cepr/canbuz-1977-vw-bus-ecu/models/OctaPAK_7_1.STEP

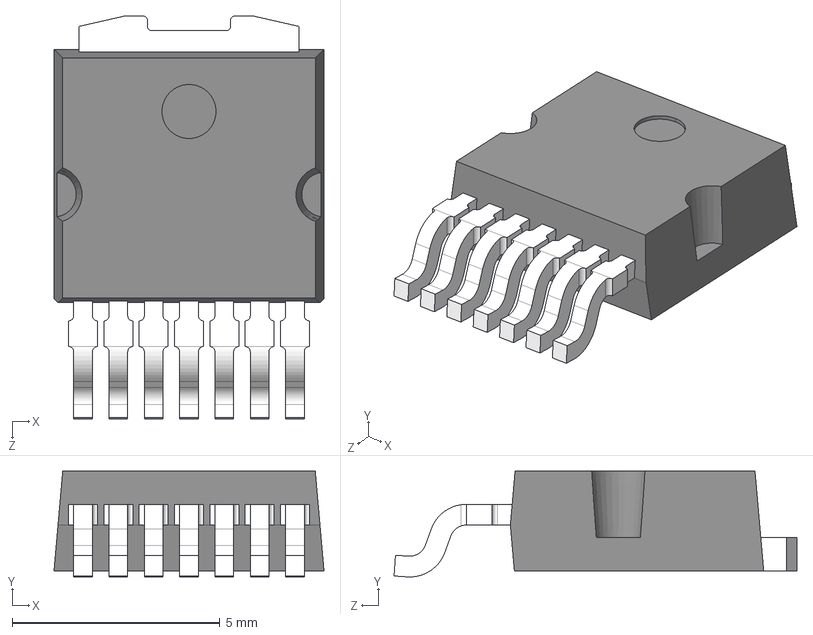
[picture p1: CAD file, 2023-06-19]
models/OctaPAK_7_1.STEP
6.50 x 2.55 x 9.70 mm
