cepr/canbuz-1977-vw-bus-ecu/models/TerminalBlock_On-Shore-Technology_ED120-3DS_1x03_P5.08mm_Vertical.step

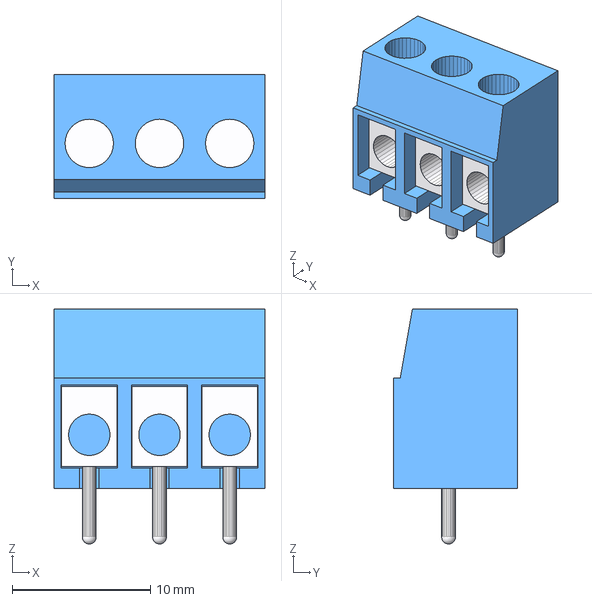
[picture p2: CAD file, 2023-06-19]
models/TerminalBlock_On-Shore-Technology_ED120-3DS_1x03_P5.08mm_Vertical.step
15.2 x 9.00 x 17.0 mm
