cepr/canbuz-1977-vw-bus-ecu/models/JST_SH_SM04B-SRSS-TB_1x04-1MP_P1.00mm_Horizontal.STEP

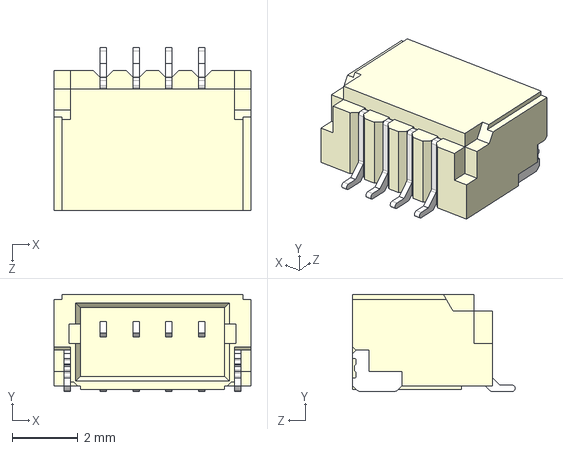
[picture p3: CAD file, 2023-06-19]
models/JST_SH_SM04B-SRSS-TB_1x04-1MP_P1.00mm_Horizontal.STEP
6.00 x 2.96 x 4.95 mm
