cepr/canbuz-1977-vw-bus-ecu/models/TerminalBlock_On-Shore-Technology_ED120-2DS_1x02_P5.08mm_Vertical.step

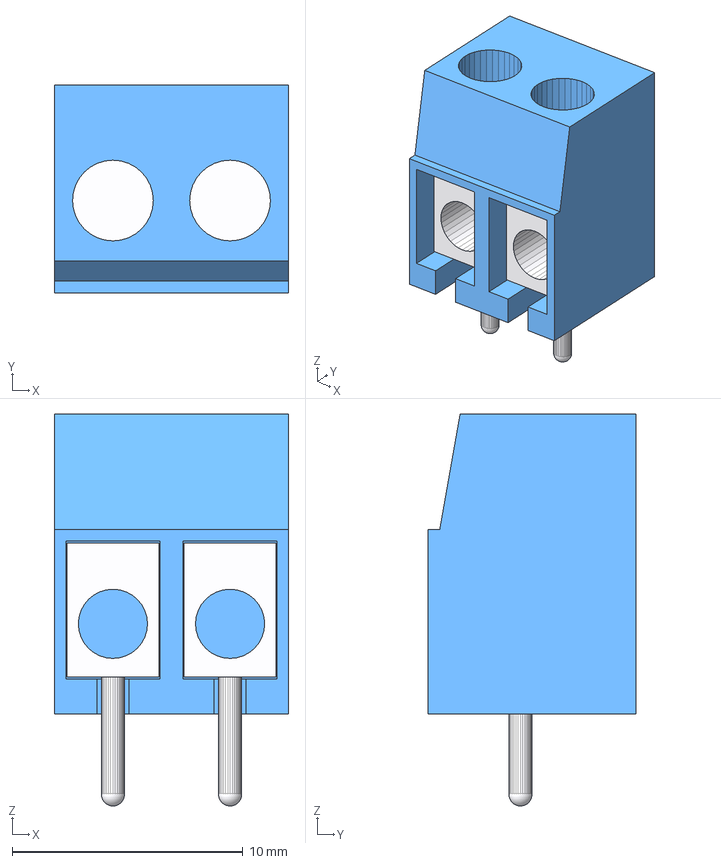
[picture p4: CAD file, 2023-06-19]
models/TerminalBlock_On-Shore-Technology_ED120-2DS_1x02_P5.08mm_Vertical.step
10.2 x 9.00 x 17.0 mm
