cepr/canbuz-1977-vw-bus-ecu/models/tsr2_3d_drawing.step

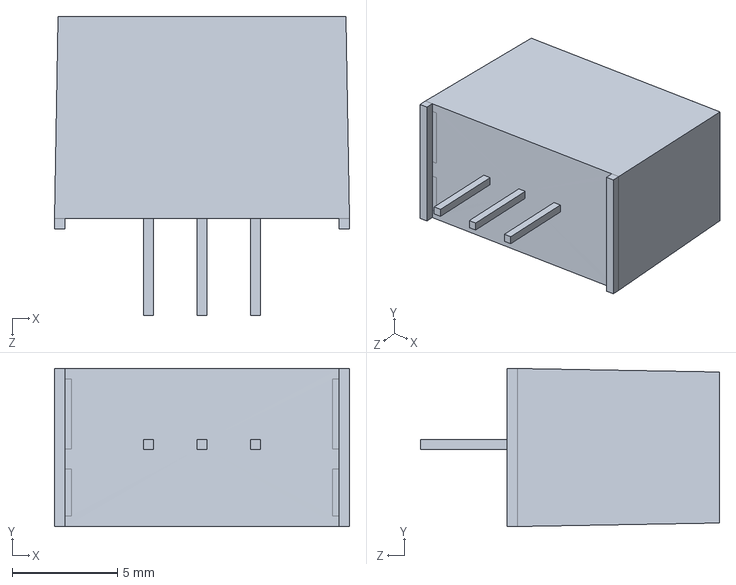
[picture p5: CAD file, 2023-06-19]
models/tsr2_3d_drawing.step
14.0 x 7.50 x 14.2 mm
