cepr/canbuz-1977-vw-bus-ecu/models/TerminalBlock_On-Shore-Technology_ED120-6DS_1x06_P5.08mm_Vertical.step

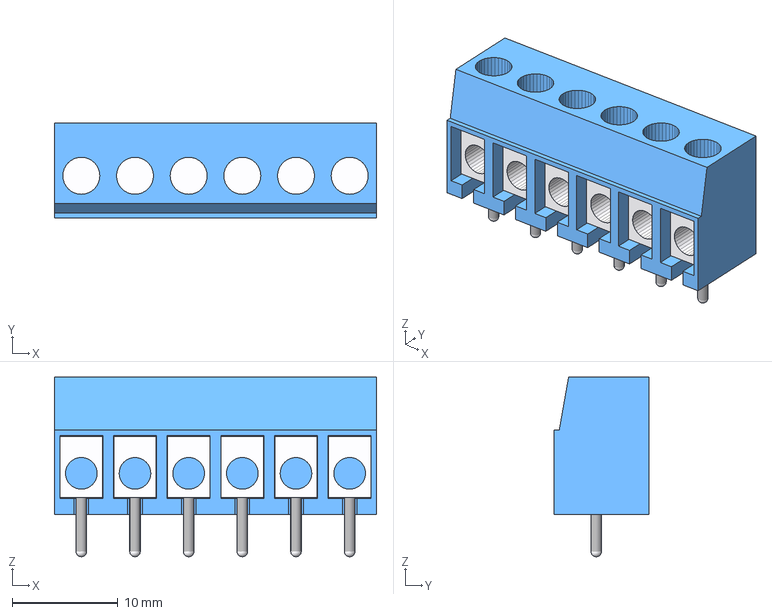
[picture p6: CAD file, 2023-06-19]
models/TerminalBlock_On-Shore-Technology_ED120-6DS_1x06_P5.08mm_Vertical.step
30.5 x 9.00 x 17.0 mm
