cepr/canbuz-1977-vw-bus-ecu/models/TerminalBlock_On-Shore-Technology_ED120-4DS_1x04_P5.08mm_Vertical.step

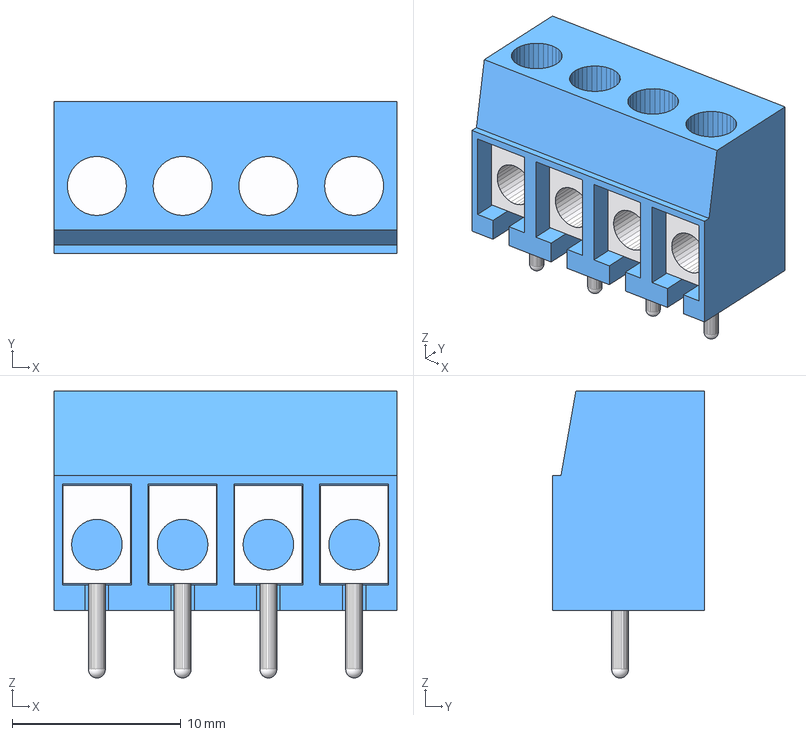
[picture p7: CAD file, 2023-06-19]
models/TerminalBlock_On-Shore-Technology_ED120-4DS_1x04_P5.08mm_Vertical.step
20.3 x 9.00 x 17.0 mm
