cepr/canbuz-1977-vw-bus-ecu/canbuz-1977-vw-bus-ecu.kicad_pcb

## KiCad design canbuz-1977-vw-bus-ecu.kicad_pcb (2023-08-31)

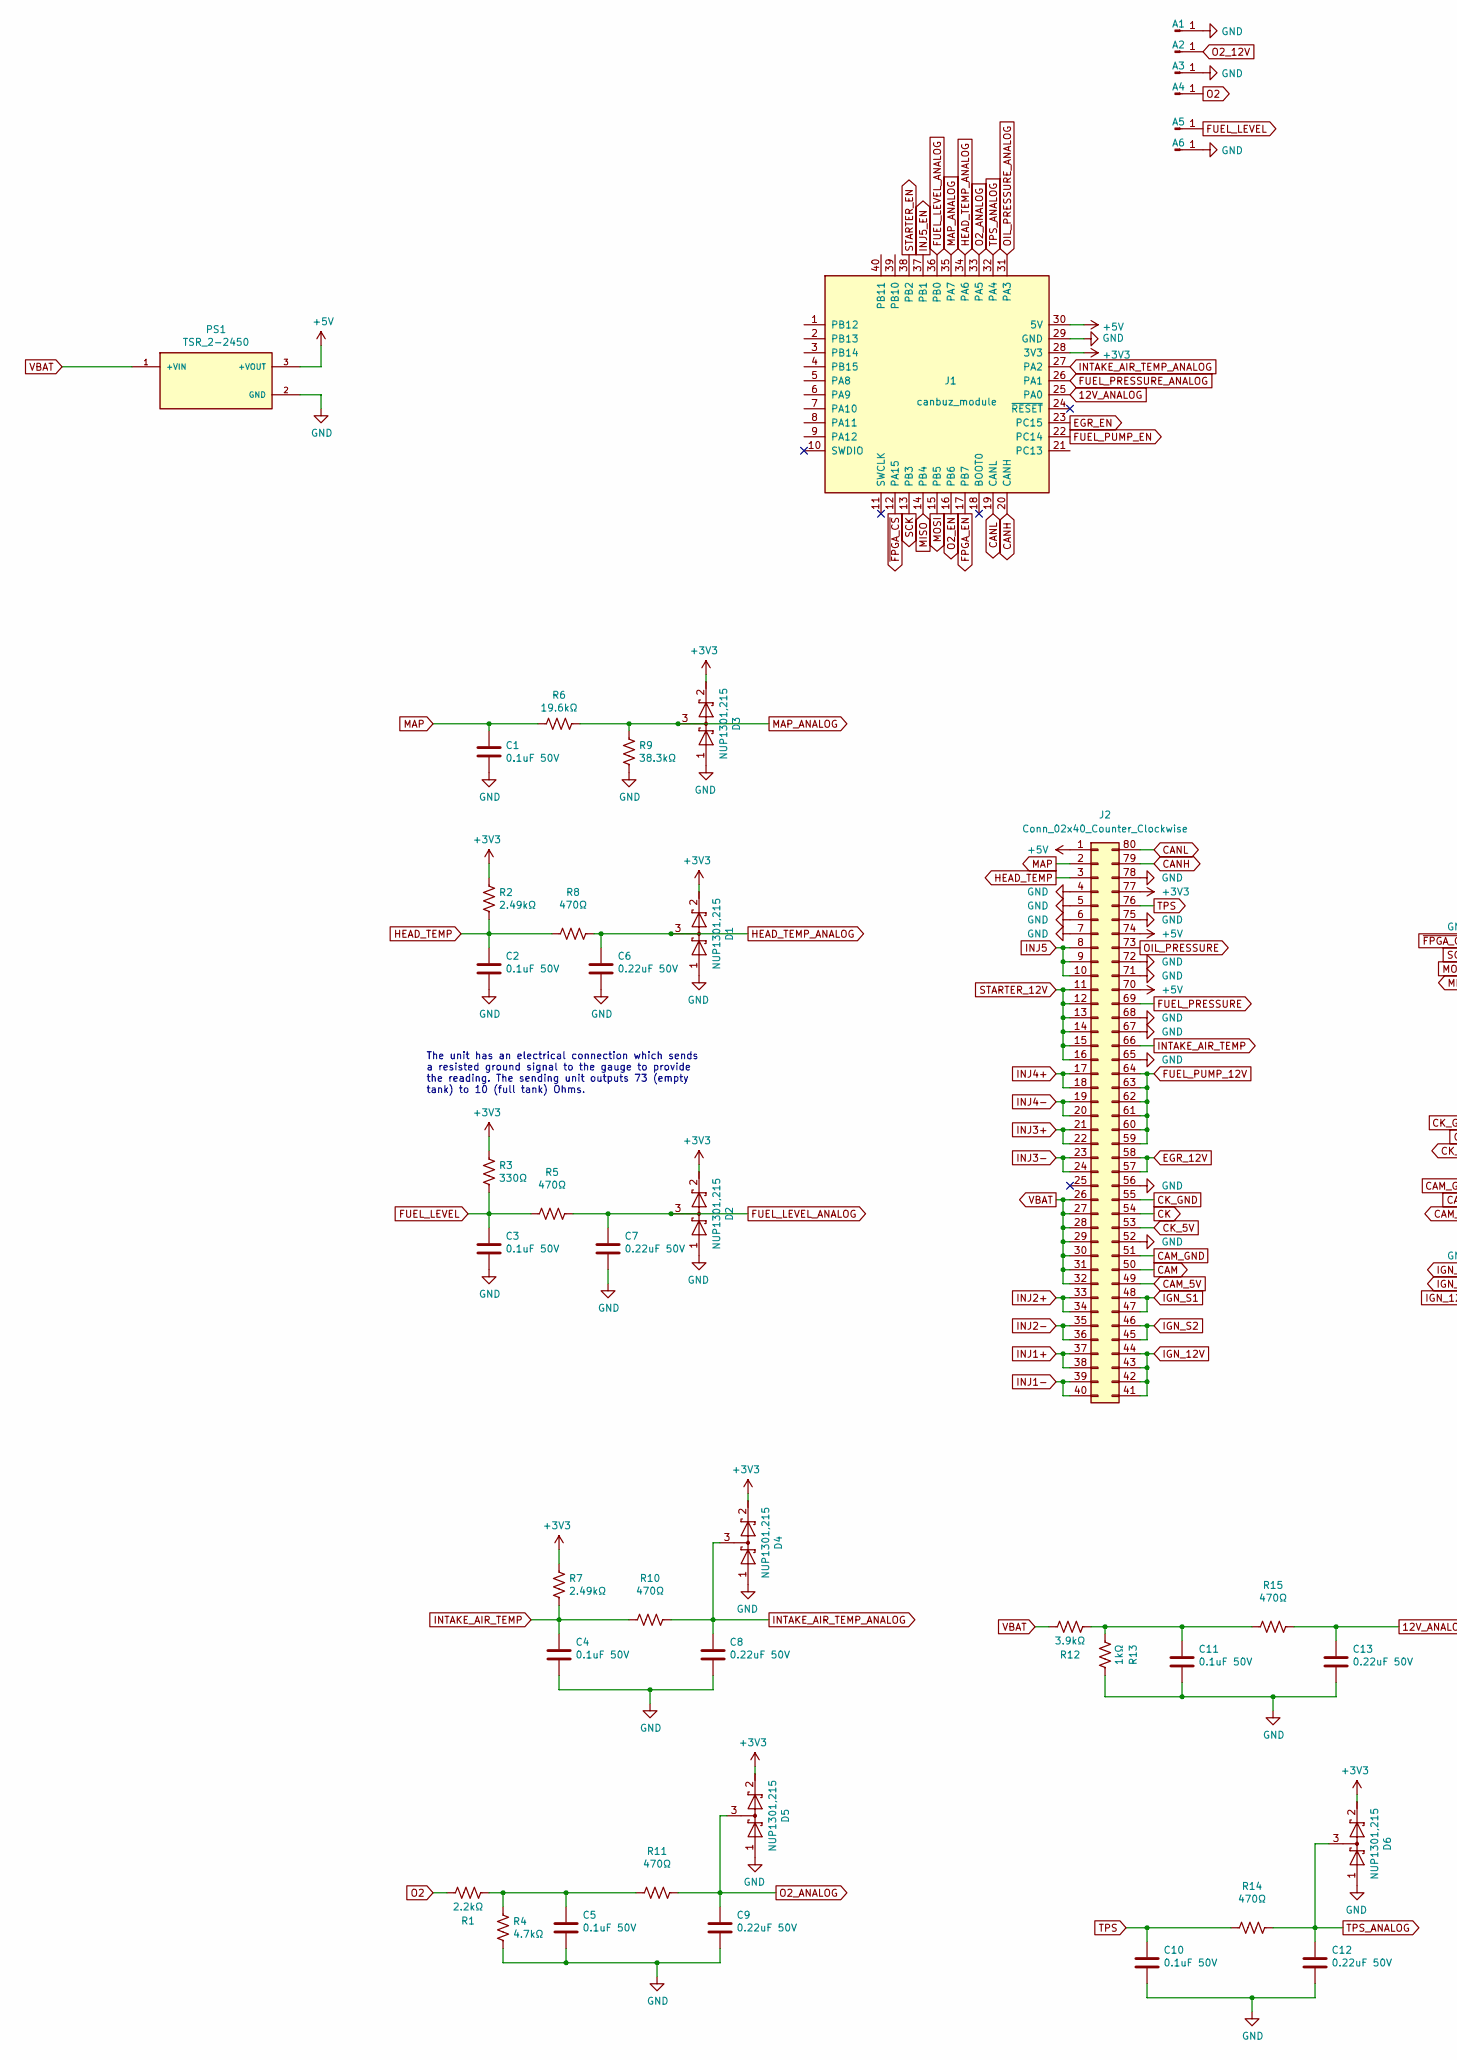
[picture p8: schematic canbuz-1977-vw-bus-ecu.kicad_sch, part in row 1, column 1]

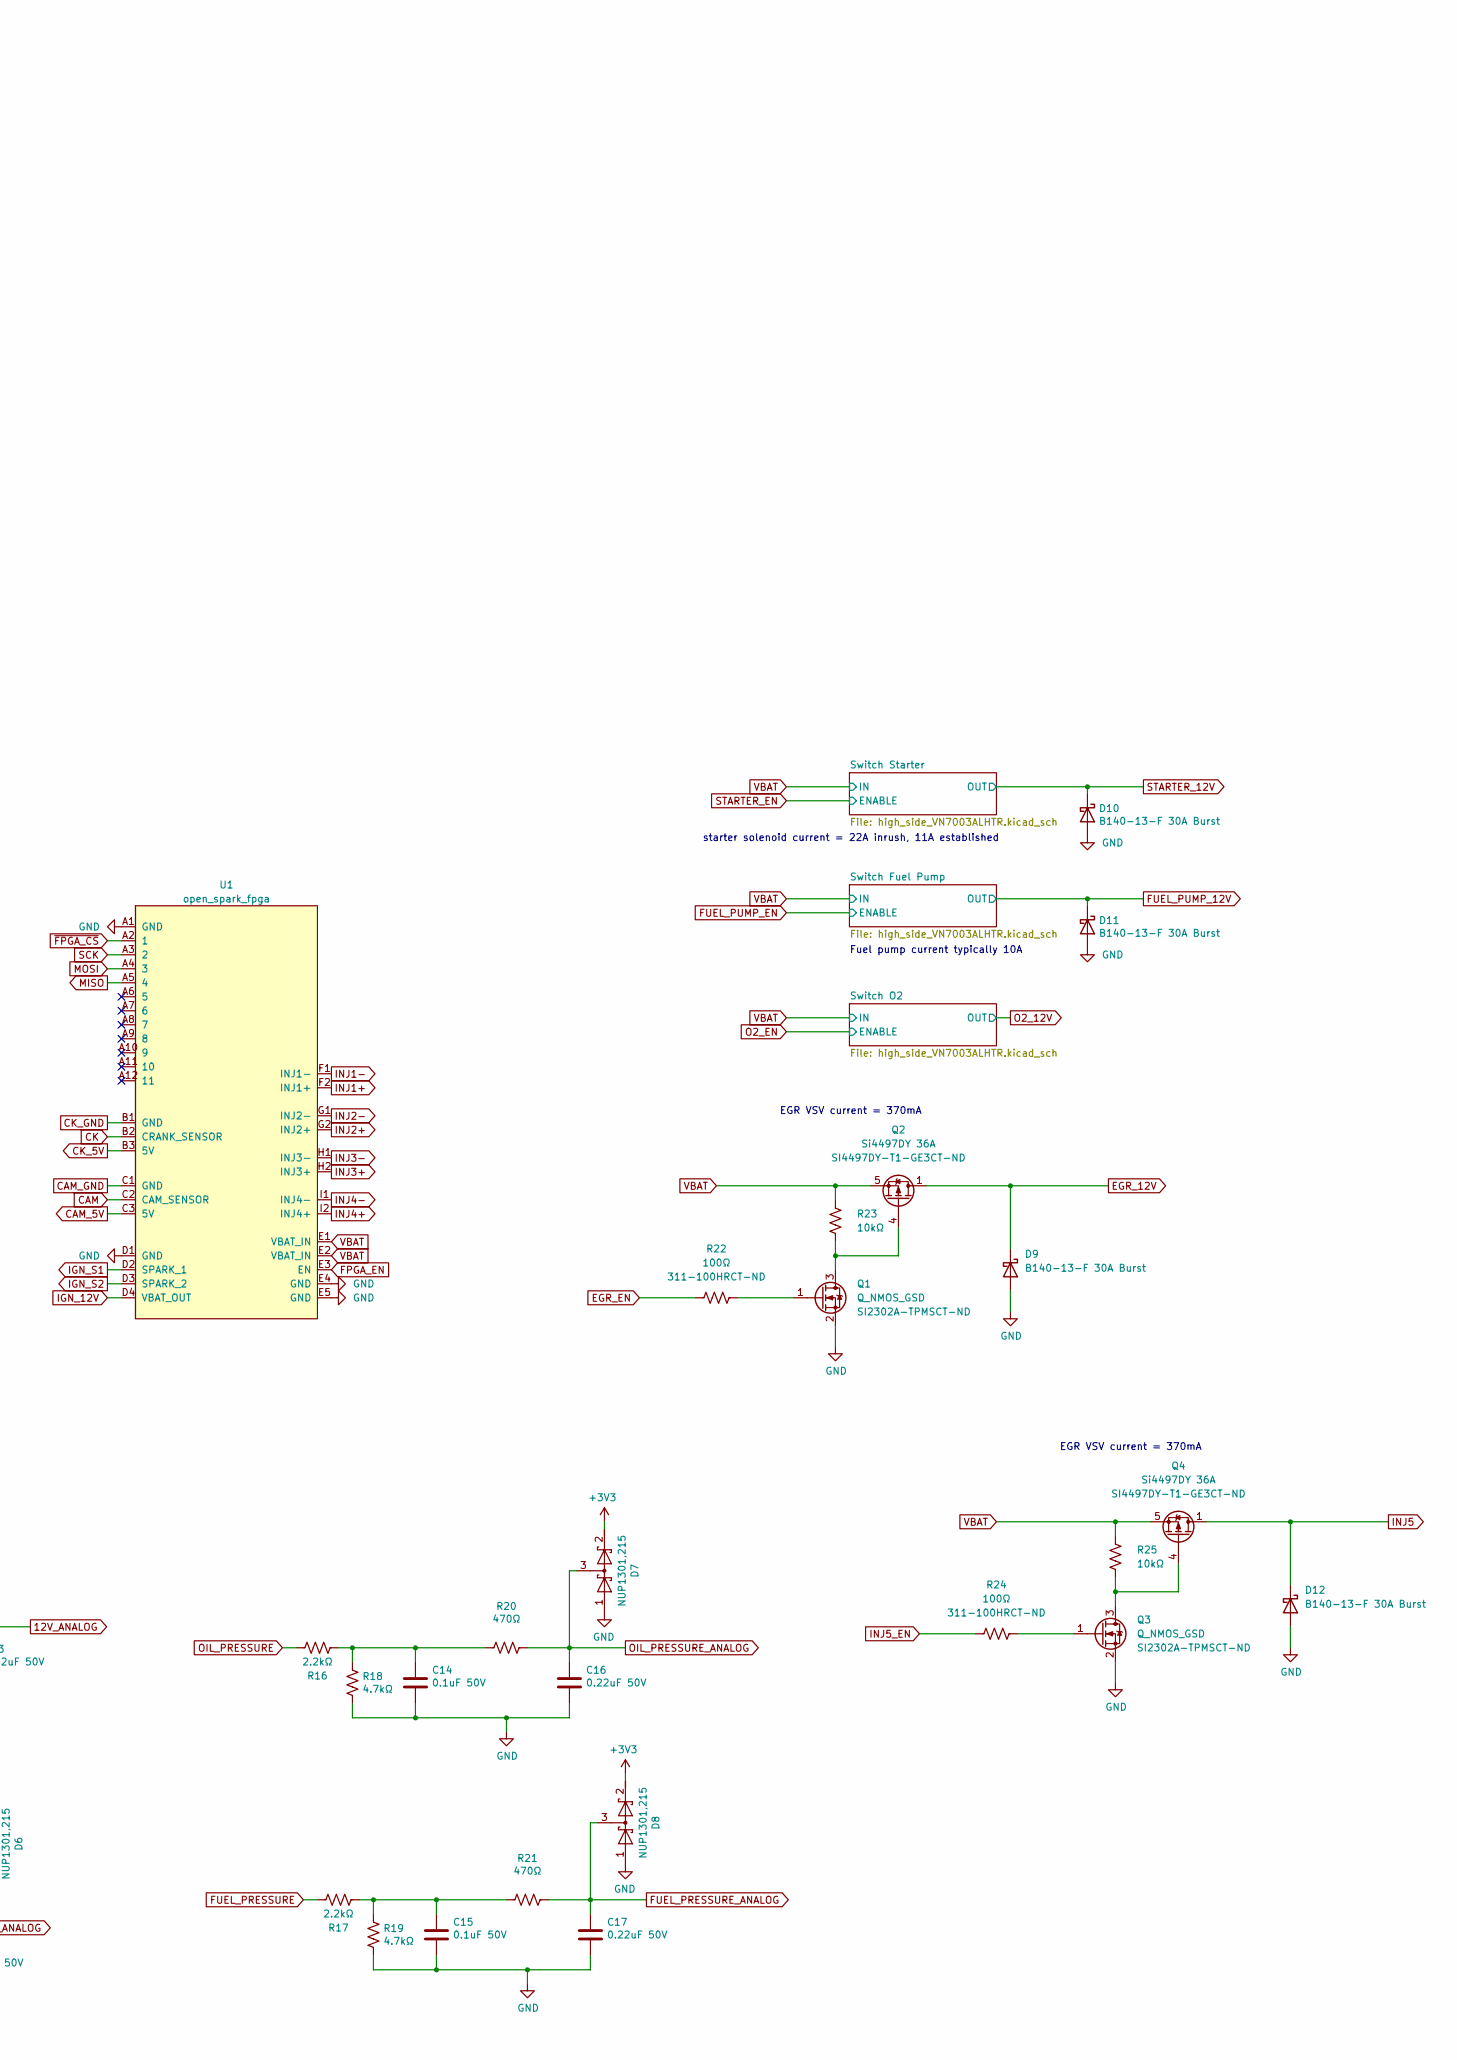
[picture p9: schematic canbuz-1977-vw-bus-ecu.kicad_sch, part in row 1, column 2]

Parts:
A1, A2, A3, A4, A5, A6: Spade_Male
C1, C2, C3, C4, C5, C10, C11, C14, C15: 0.1uF 50V; C_0805_2012Metric_Pad1.18x1.45mm_HandSolder; Part KAF21BR71H104KT; DigiKey 478-6048-1-ND
C6, C7, C8, C9, C12, C13, C16, C17: 0.22uF 50V; C_0805_2012Metric_Pad1.18x1.45mm_HandSolder; Part CGA4J2X7R1H224K125AA; DigiKey 445-5683-1-ND
D1, D2, D3, D4, D5, D6, D7, D8: NUP1301,215; SOT-23; Part NUP1301,215; DigiKey 1727-5056-1-ND
D9, D10, D11, D12: B140-13-F 30A Burst; D_SMA; Part B340A-13-F
J1: canbuz_module; canbuz-module
J2: Conn_02x40_Counter_Clockwise; canbuz-1977-vw-bus-ecu-connector
PS1: TSR_2-2450; CONV_TSR_2-2450; Part TSR 2-2450; DigiKey 1951-2692-ND
Q1, Q3: Q_NMOS_GSD; SOT-23; Part SI2302A-TP; DigiKey SI2302A-TPMSCT-ND
Q2, Q4: Si4497DY 36A; SO-8_3.9x4.9mm_P1.27mm; Part SI4497DY-T1-GE3; DigiKey SI4497DY-T1-GE3CT-ND
R1, R16, R17: 2.2kΩ; R_0603_1608Metric_Pad0.98x0.95mm_HandSolder; Part ERJ-3GEYJ222V
R2, R7: 2.49kΩ; R_0603_1608Metric_Pad0.98x0.95mm_HandSolder; Part RK73H1JTTD2491F
R3: 330Ω; R_0603_1608Metric_Pad0.98x0.95mm_HandSolder
R4, R18, R19: 4.7kΩ; R_0603_1608Metric_Pad0.98x0.95mm_HandSolder; Part RC0603FR-074K7L
R5, R8, R10, R11, R14, R15, R20, R21: 470Ω; R_0603_1608Metric_Pad0.98x0.95mm_HandSolder; Part RC0603JR-07470RL
R6: 19.6kΩ; R_0603_1608Metric_Pad0.98x0.95mm_HandSolder; Part RC0603FR-0719K6L
R9: 38.3kΩ; R_0603_1608Metric_Pad0.98x0.95mm_HandSolder; Part RC0603FR-0738K3L
R12: 3.9kΩ; R_0603_1608Metric_Pad0.98x0.95mm_HandSolder; Part RC0603FR-073K9L
R13: 1kΩ; R_0603_1608Metric_Pad0.98x0.95mm_HandSolder; Part RC0603FR-071KL
R22, R24: 100Ω; R_0603_1608Metric_Pad0.98x0.95mm_HandSolder; Part RC0603FR-07100RL; DigiKey 311-100HRCT-ND
R23, R25: 10kΩ; R_0603_1608Metric_Pad0.98x0.95mm_HandSolder; Part RC0603FR-0710KL
U1: open_spark_fpga

Connections:
12V_ANALOG: C13.1, J1.25 (PA0), R15.1
+3V3: D1.2 (K), D2.2 (K), D3.2 (K), D4.2 (K), D5.2 (K), D6.2 (K), D7.2 (K), D8.2 (K), J1.28 (3V3), J2.77, R2.2, R3.2, R7.2
+5V: J1.30 (5V), J2.1, J2.70, J2.74, PS1.3 (+VOUT)
CAM: J2.50, U1.C2 (CAM_SENSOR)
CAM_5V: J2.49, U1.C3 (5V)
CAM_GND: J2.51, U1.C1 (GND)
CANH: J1.20 (CANH), J2.79
CANL: J1.19 (CANL), J2.80
CK: J2.54, U1.B2 (CRANK_SENSOR)
CK_5V: J2.53, U1.B3 (5V)
CK_GND: J2.55, U1.B1 (GND)
EGR_12V: D9.1 (K), J2.57, J2.58, Q2.1 (D), Q2.2 (D), Q2.3 (D)
EGR_EN: J1.23 (PC15), R22.1
FPGA_EN: J1.17 (PB7), U1.E3 (EN)
FUEL_LEVEL: A5.1, C3.1, R3.1, R5.2
FUEL_LEVEL_ANALOG: C7.1, D2.3 (common), J1.36 (PB0), R5.1
FUEL_PRESSURE: J2.69, R17.1
FUEL_PRESSURE_ANALOG: C17.1, D8.3 (common), J1.26 (PA1), R21.1
FUEL_PUMP_12V: D11.1 (K), J2.59, J2.60, J2.61, J2.62, J2.63, J2.64; also elsewhere on the board
FUEL_PUMP_EN: J1.22 (PC14); also elsewhere on the board
GND: A1.1, A3.1, A6.1, C1.2, C2.2, C3.2, C4.2, C5.2, C6.2, C7.2, C8.2, C9.2, C10.2, C11.2, C12.2, C13.2, C14.2, C15.2, C16.2, C17.2, D1.1 (A), D2.1 (A), D3.1 (A), D4.1 (A), D5.1 (A), D6.1 (A), D7.1 (A), D8.1 (A), D9.2 (A), D10.2 (A), D11.2 (A), D12.2 (A), J1.29 (GND), J2.4, J2.5, J2.6, J2.7, J2.52, J2.56, J2.65, J2.67, J2.68, J2.71, J2.72, J2.75, J2.78, PS1.2 (GND), Q1.2 (S), Q3.2 (S), R4.1, R9.2, R13.1, R18.1, R19.1, U1.A1 (GND), U1.D1 (GND), U1.E4 (GND), U1.E5 (GND); also elsewhere on the board
HEAD_TEMP: C2.1, J2.3, R2.1, R8.2
HEAD_TEMP_ANALOG: C6.1, D1.3 (common), J1.34 (PA6), R8.1
IGN_12V: J2.41, J2.42, J2.43, J2.44, U1.D4 (VBAT_OUT)
IGN_S1: J2.47, J2.48, U1.D2 (SPARK_1)
IGN_S2: J2.45, J2.46, U1.D3 (SPARK_2)
INJ1+: J2.37, J2.38, U1.F2 (INJ1+)
INJ1-: J2.39, J2.40, U1.F1 (INJ1-)
INJ2+: J2.33, J2.34, U1.G2 (INJ2+)
INJ2-: J2.35, J2.36, U1.G1 (INJ2-)
INJ3+: J2.21, J2.22, U1.H2 (INJ3+)
INJ3-: J2.23, J2.24, U1.H1 (INJ3-)
INJ4+: J2.17, J2.18, U1.I2 (INJ4+)
INJ4-: J2.19, J2.20, U1.I1 (INJ4-)
INJ5: D12.1 (K), J2.8, J2.9, J2.10, Q4.1 (D), Q4.2 (D), Q4.3 (D)
INJ5_EN: J1.37 (PB1), R24.1
INTAKE_AIR_TEMP: C4.1, J2.66, R7.1, R10.2
INTAKE_AIR_TEMP_ANALOG: C8.1, D4.3 (common), J1.27 (PA2), R10.1
MAP: C1.1, J2.2, R6.2
MAP_ANALOG: D3.3 (common), J1.35 (PA7), R6.1, R9.1
MISO: J1.14 (PB4), U1.A5 (4)
MOSI: J1.15 (PB5), U1.A4 (3)
unnamed: C5.1, R1.2, R4.2, R11.2
unnamed: C11.1, R12.2, R13.2, R15.2
unnamed: C14.1, R16.2, R18.2, R20.2
unnamed: C15.1, R17.2, R19.2, R21.2
unnamed: Q1.1 (G), R22.2
unnamed: Q1.3 (D), Q2.4 (G), R23.1
unnamed: Q3.1 (G), R24.2
unnamed: Q3.3 (D), Q4.4 (G), R25.1
O2: A4.1, R1.1
O2_12V: A2.1; also elsewhere on the board
O2_ANALOG: C9.1, D5.3 (common), J1.33 (PA5), R11.1
O2_EN: J1.16 (PB6); also elsewhere on the board
OIL_PRESSURE: J2.73, R16.1
OIL_PRESSURE_ANALOG: C16.1, D7.3 (common), J1.31 (PA3), R20.1
SCK: J1.13 (PB3), U1.A3 (2)
STARTER_12V: D10.1 (K), J2.11, J2.12, J2.13, J2.14, J2.15, J2.16; also elsewhere on the board
STARTER_EN: J1.38 (PB2); also elsewhere on the board
TPS: C10.1, J2.76, R14.2
TPS_ANALOG: C12.1, D6.3 (common), J1.32 (PA4), R14.1
VBAT: J2.26, J2.27, J2.28, J2.29, J2.30, J2.31, J2.32, PS1.1 (+VIN), Q2.5 (S), Q2.6 (S), Q2.7 (S), Q2.8 (S), Q4.5 (S), Q4.6 (S), Q4.7 (S), Q4.8 (S), R12.1, R23.2, R25.2, U1.E1 (VBAT_IN), U1.E2 (VBAT_IN); also elsewhere on the board
~FPGA_CS: J1.12 (PA15), U1.A2 (1)

Notes on the sheet:
EGR VSV current = 370mA
The unit has an electrical connection which sends a resisted ground signal to the gauge to provide the reading. The sending unit outputs 73 (empty tank) to 10 (full tank) Ohms.
starter solenoid current = 22A inrush, 11A established
Fuel pump current typically 10A

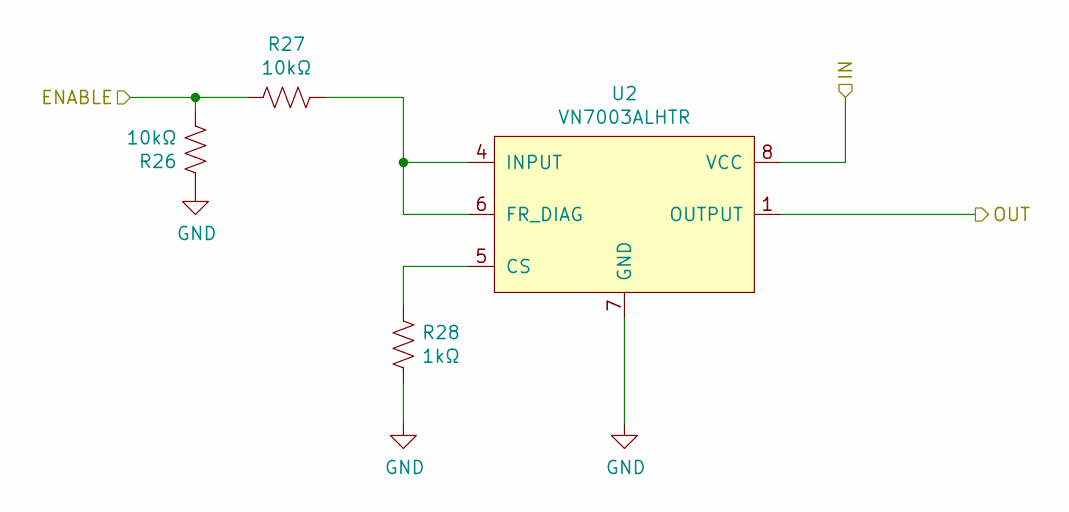
[picture p10: schematic high_side_VN7003ALHTR.kicad_sch]

Parts:
R26, R27: 10kΩ; R_0603_1608Metric_Pad0.98x0.95mm_HandSolder; Part RC0603FR-0710KL
R28: 1kΩ; R_0603_1608Metric_Pad0.98x0.95mm_HandSolder; Part RC0603FR-071KL
U2: VN7003ALHTR; OctaPAK_7_1; Part VN7003AHTR; DigiKey 497-16716-1-ND

Connections:
GND: R26.2, R28.1, U2.7 (GND); also elsewhere on the board
unnamed: R27.1, U2.4 (INPUT), U2.6 (FR_DIAG)
unnamed: R28.2, U2.5 (CS)
STARTER_12V: U2.1 (OUTPUT), U2.2 (OUTPUT), U2.3 (OUTPUT); also elsewhere on the board
STARTER_EN: R26.1, R27.2; also elsewhere on the board
VBAT: U2.8 (VCC); also elsewhere on the board

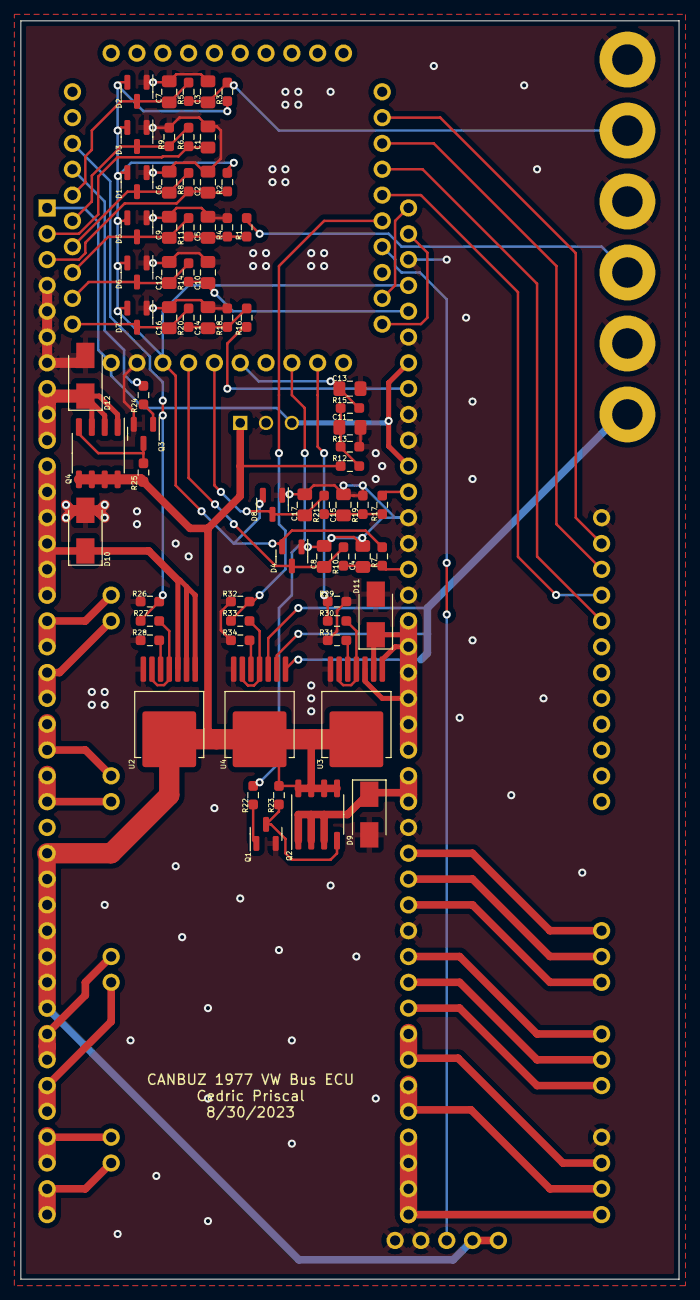
[picture p11: board canbuz-1977-vw-bus-ecu.kicad_pcb from above]

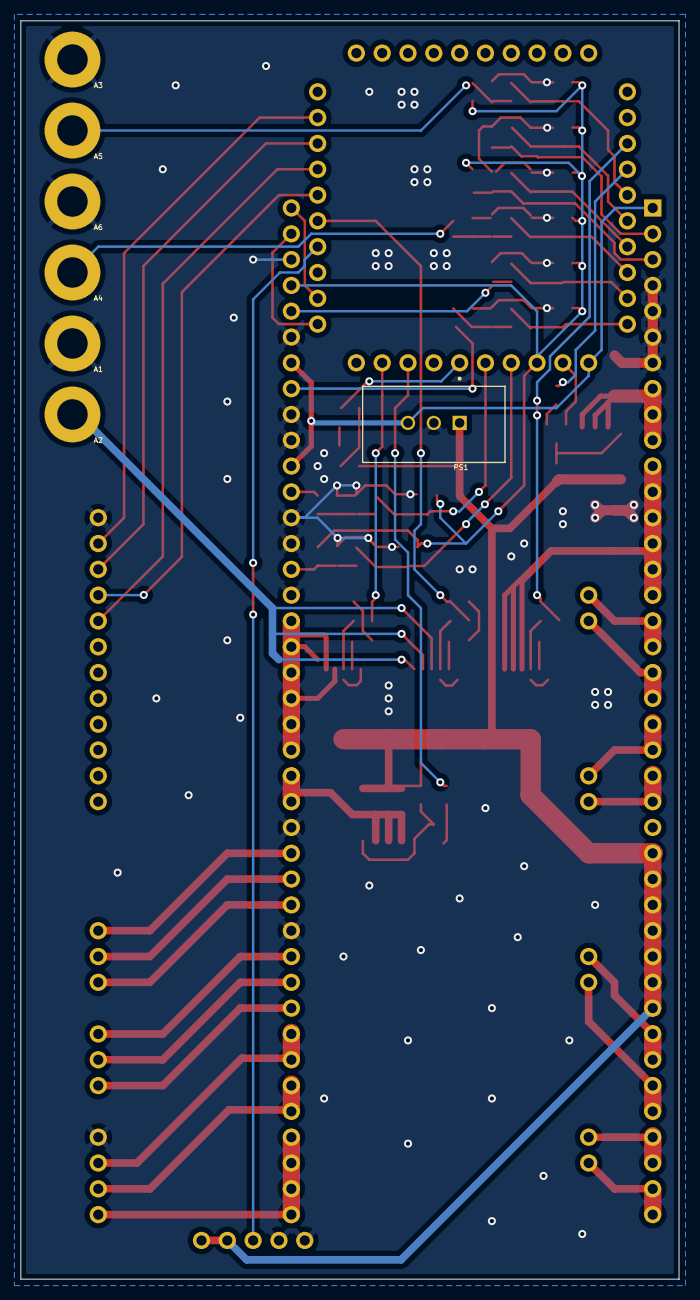
[picture p12: board canbuz-1977-vw-bus-ecu.kicad_pcb from below]

Board: 2 copper layers, 64.8 x 123.8 mm, 80 parts (9 on the bottom side), 69 nets.

Other parts of the board:
R29, R30, R32, R33: 10kΩ; R_0603_1608Metric_Pad0.98x0.95mm_HandSolder
R31, R34: 1kΩ; R_0603_1608Metric_Pad0.98x0.95mm_HandSolder
U3, U4: VN7003ALHTR; OctaPAK_7_1

Their connections:
FUEL_PUMP_12V: U3.1 (OUTPUT), U3.2 (OUTPUT), U3.3 (OUTPUT); also elsewhere on the board
FUEL_PUMP_EN: R29.1, R30.2; also elsewhere on the board
GND: R29.2, R31.1, R32.2, R34.1, U3.7 (GND), U4.7 (GND); also elsewhere on the board
unnamed: R30.1, U3.4 (INPUT), U3.6 (FR_DIAG)
unnamed: R31.2, U3.5 (CS)
unnamed: R33.1, U4.4 (INPUT), U4.6 (FR_DIAG)
unnamed: R34.2, U4.5 (CS)
O2_12V: U4.1 (OUTPUT), U4.2 (OUTPUT), U4.3 (OUTPUT); also elsewhere on the board
O2_EN: R32.1, R33.2; also elsewhere on the board
VBAT: U3.8 (VCC), U4.8 (VCC); also elsewhere on the board
