cepr/canbuz-1977-vw-bus-ecu/(commit log)

2023-07-15 Rev 1.0
    [canbuz-1977-vw-bus-ecu-B_Cu.gbl, canbuz-1977-vw-bus-ecu-B_Mask.gbs, canbuz-1977-vw-bus-ecu-B_Paste.gbp, canbuz-1977-vw-bus-ecu-B_Silkscreen.gbo, canbuz-1977-vw-bus-ecu-Edge_Cuts.gm1, canbuz-1977-vw-bus-ecu-F_Cu.gtl, canbuz-1977-vw-bus-ecu-F_Mask.gts, canbuz-1977-vw-bus-ecu-F_Paste.gtp]
2023-08-31 rev 08/30/2023
    [canbuz-1977-vw-bus-ecu.kicad_pcb, canbuz-1977-vw-bus-ecu.kicad_sch, high_side_VN7003ALHTR.kicad_sch]
